JeremyProffittOrg/10-inch-unibody-rack/assets/acer-dgx-stack-concept_front.png

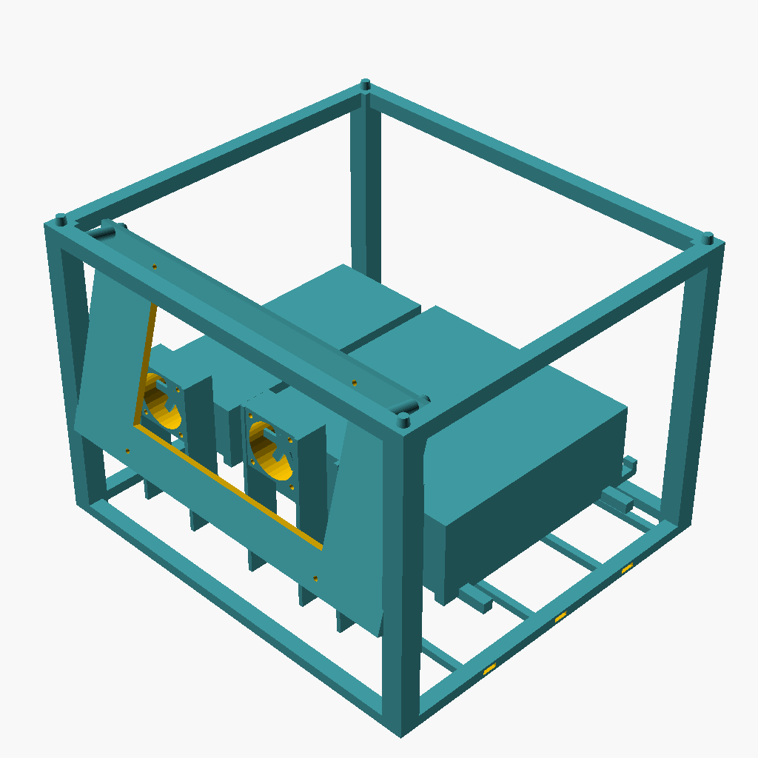
assets/acer-dgx-stack-concept_front.png
