JeremyProffittOrg/10-inch-unibody-rack/assets/acer-dgx-stack-concept_rear.png

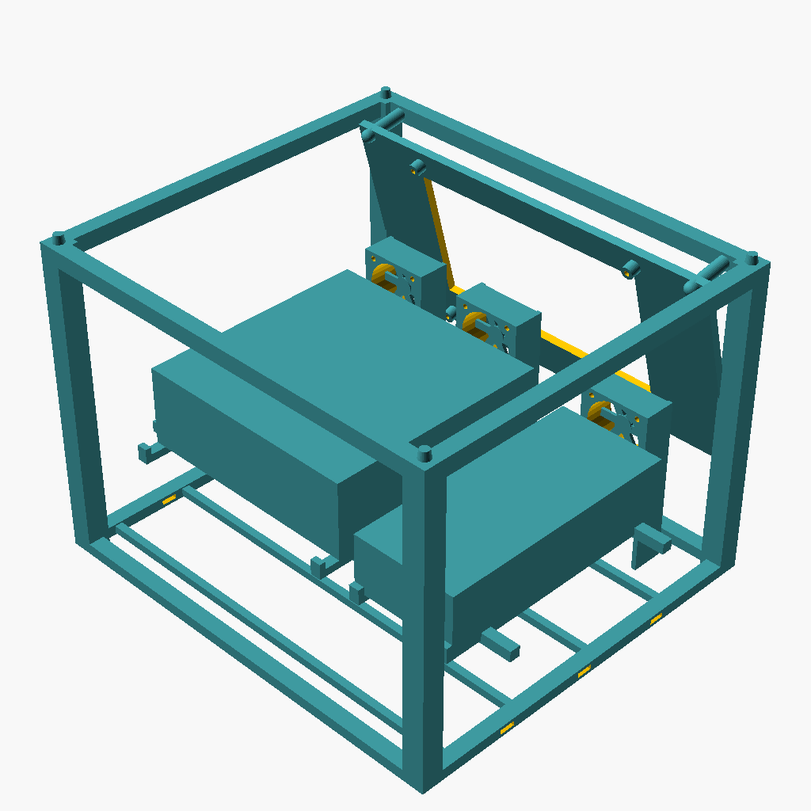
assets/acer-dgx-stack-concept_rear.png
