JeremyProffittOrg/10-inch-unibody-rack/assets/acer-dgx-stack-enclosure-v2_front.png

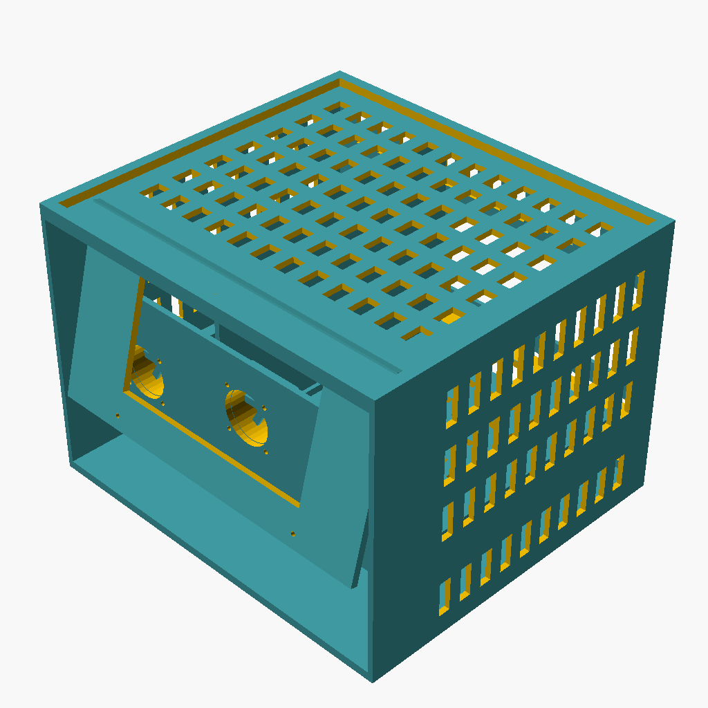
assets/acer-dgx-stack-enclosure-v2_front.png
