JeremyProffittOrg/10-inch-unibody-rack/assets/acer-dgx-stack-enclosure-v2_rear.png

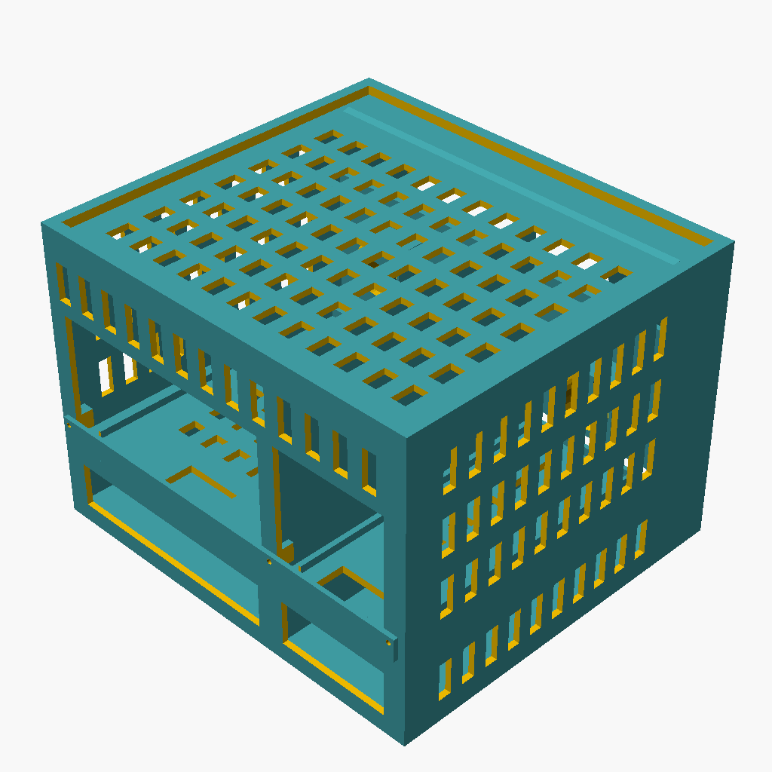
assets/acer-dgx-stack-enclosure-v2_rear.png
