JeremyProffittOrg/10-inch-unibody-rack/(list of files, cad)

Other CAD files:
acer-dgx-enclosure-v10.scad
acer-dgx-enclosure-v11.scad
acer-dgx-enclosure-v12.scad
acer-dgx-enclosure-v3.scad
acer-dgx-enclosure-v4.scad
acer-dgx-enclosure-v5.scad
acer-dgx-enclosure-v6.scad
acer-dgx-enclosure-v7.scad
acer-dgx-enclosure-v8.scad
acer-dgx-enclosure-v9.scad
