JeremyProffittOrg/10-inch-unibody-rack/(commit log)

2026-11-08 Add stackable Acer enclosure with removable M3 fan plate
    [acer-dgx-enclosure-v3.scad, acer-dgx-enclosure-v4.scad, acer-dgx-enclosure-v5.scad, acer-dgx-enclosure-v6.scad, acer-dgx-enclosure-v7.scad, acer-dgx-enclosure-v8.scad, acer-dgx-stack-concept.scad, acer-dgx-stack-enclosure-v2.scad]
2026-11-11 Add DGX enclosure revisions through v13 and support audit
    [acer-dgx-enclosure-v10.scad, acer-dgx-enclosure-v10b.scad, acer-dgx-enclosure-v11.scad, acer-dgx-enclosure-v12.scad, acer-dgx-enclosure-v13.scad, acer-dgx-enclosure-v9.scad]
